GAndrews98/SeaGlide/README.md

# SeaGlide
### SeaGlide AUV files included in this repository:
* Detailed Build Manual
* 3D Printed Parts
* IRRemote Header Files
* Glider Arduino Code V1_0.ino
* Bill of Materials
* Folder of advanced firmware for gliders with Temp/Depth sensors

### Links to necessary Programs and Drivers
[Download: Arduino IDE](http://www.arduino.org/downloads)

[Download: FTDI Drivers for Windows](http://www.ftdichip.com/Drivers/VCP.htm)
