GAndrews98/SeaGlide/Sensor_Firmware/ReadMe.md

# Sensor_Firmware

Arduino code to be run on gliders utilizing temperature and depth sensors.
