GAndrews98/SeaGlide/SeaGlideBOM.xlsx

SeaGlide Bill of Materials | Item | #/Glider |  | #/pack | Item # |  | Glider/Pack | price | Price/ glider |  | link | http://www.mcmaster.com/#
McMaster | 5/16"-18 Bolt 2-1/4" Length | 1 |  | 10 | 92240A932 (http://www.mcmaster.com/) |  | 0.10 | $4.73 | $0.47 |  | http://www.mcmaster.com/#92240A932
 | Tygon Tubing | 1.5 | in | 12 | 5186T14 (http://www.mcmaster.com/) |  | 0.12 | $1.77 | $0.22 |  | http://www.mcmaster.com/#5186T14
 | Steel Bar 1/4"x1"x6" | 2 |  | 1 | 8910K383 |  | 2.00 | $2.75 | $5.50 |  | http://www.mcmaster.com/#8910K383
 | small zip ties | 3 |  | 100 | 6705K31 (http://www.mcmaster.com/) |  | 0.03 | $7.12 | $0.21 |  | http://www.mcmaster.com/#6705K31
 | large zip tie | 2 |  | 100 | 7130K56 (http://www.mcmaster.com/) | 10 | 0.02 | $14.75 | $0.29 |  | http://www.mcmaster.com/#7130K56
 | Brass 6/16-18 nuts (jam nuts, thin) | 1 |  | 25 | 92174A030 (http://www.mcmaster.com/) |  | 0.04 | $6.44 | $0.26 | $1.66 | http://www.mcmaster.com/#92174A030
 | 3/8" ID 1" OD washer Stainless | 1 |  | 100 | 92141A051 |  | 0.01 | $7.66 | $0.08 | $0.59 | http://www.mcmaster.com/#92141A051
 | #6 1/2" Thread-Cutting Screws | 15 |  | 100 | 94629A680 |  | 0.15 | $5.59 | $0.84 |  | http://www.mcmaster.com/#94629A680
 | #2 x3/8 Sheet Metal Stainless | 12 |  | 100 | 90065A079 |  | 0.12 | $3.10 | $0.37 |  | http://www.mcmaster.com/#90065a079/=snxfsx
 | #4-40 washer | 11 |  | 500 | 98019A309 (http://www.mcmaster.com/) |  | 0.022 | $9.63 | $0.21 |  | http://www.mcmaster.com/#98019A309
 | Polystyrine sheet 1/16" | 1 ft^2 |  | 40x72 | 8734K22 (http://www.mcmaster.com/) |  | 0.06 | $29.03 | $1.61 |  | http://www.mcmaster.com/#8734K22
 | Heat Shrink Tubing 1/8-1/16 ID | 4 | in | 48 | 7856K133 (http://www.mcmaster.com/) |  | 0.08 | $1.82 | $0.15 |  | http://www.mcmaster.com/#7856K133
 | RTV silicone | 0.03 | oz | 1 | 7474A14 |  | 0.03 | $6.04 | $0.20 |  | http://www.mcmaster.com/#7474A14
 | 3M Super33+ Electrical Tape | 1 | in | 66 | 76455A22 |  | 0.0152 | $5.65 | $0.09 |  | http://www.mcmaster.com/
Amazon | Ballast Weight strip (3oz) | 1 |  | 6 |  |  | 0.167 | $9.25 | $1.54 |  | http://www.amazon.com/Motion-Pro-08-0455-Black-Weight/dp/B002KQY92W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
 | Li-Ion 9V 4 Pack +Charger | 1 |  | 4 |  |  | 0.250 | $22.99 | $5.75 |  | http://www.amazon.com/EBL-Self-Discharge-Lithium-ion-Rechargeable-Batteries/dp/B00EQ3U2AA
 | popsicle stick | 1 |  | 100 |  |  | 0.01 | $5.67 | $0.06 |  | http://www.amazon.com/Wooden-Treat-Sticks-100-Pcs/dp/B000MMKPEC
 | 3D printed plastic parts | 6 |  |  |  |  |  |  |  | est | $15.00 | jyapchua@gmail.com | or from someone on http://www.makexyz.com/
 | 3D Printer Plus 5 Reels of PLA | 1 |  | 100 |  |  | 0.01 | $924.99 | $9.25 |  | XYZ Printer (700+5*45)
Walmart | BBs (~200grams) | 1 |  | 7 |  |  | 0.14 | $6.97 | $1.00 |  | http://www.walmart.com/ip/Daisy-6000ct-BB-Ammo/15729973
Digikey | 3' Male A USB -> Mini B Male USB | 1 |  | 100 | Q362-ND |  | 0.01 | $176.04 | $1.76 |  | http://www.digikey.com/product-detail/en/3021003-03/Q362-ND/1531289
 | 10k trim pot | 1 |  | 100 | D4AA14-ND | $0.20 | 0.01 | $20.02 | $0.20 |  | http://www.digikey.com/scripts/DkSearch/dksus.dll?WT.z_header=search_go&lang=en&x=0&y=0&cur=USD
 | 5 ohm 0.6W resistor | 1 |  | 100 | BC4.70ZCT-ND |  | 0.01 | $0.00 | $0.00 |  | http://www.digikey.com/product-detail/en/MBB02070C4708FRP00/BC4.70ZCT-ND/2945833
 | 9V Battery Clip | 1 |  | 100 | 36-232-ND |  | 0.01 | $34.76 | $0.35 |  | http://www.digikey.com/product-detail/en/232/36-232-ND/303804
 | push push power switch | 1 |  | 100 | 515PB-ND |  | 0.01 | $134.24 | $1.34 |  | http://www.digikey.com/product-detail/en/40-3979-00/515PB-ND/523397
 | 12 Pin Right Angle Female Header | 1 |  | 100 | S5448-ND |  | 0.01 | $61.00 | $0.61 |  | http://www.digikey.com/product-detail/en/PPTC121LGBN-RC/S5448-ND/775906 |  |  |  | save by buying from DigiKey |  | 0.5
 | male header rt angle 0.1 pitch 36pin | 0.5 |  | 50 | WM50026-36-ND |  | 0.01 | $75.42 | $0.75 |  | http://www.digikey.com/product-detail/en/0022288363/WM50026-36-ND/314241 |  |  |  |  |  | 0.5
 | hook up wire / ribbin cable | 12 | in | 100 | T1309-30-ND |  | 0.01 | $36.01 | $0.36 |  | http://www.digikey.com/product-detail/en/30-00419/T1309-30-ND/5638242
 | Tactile Switch w/ long stem | 1 |  | 100 | EG4566CT-ND | $0.26 | 0.01 | $0.27 | $0.002665 |  | http://www.digikey.com/product-detail/en/TL59FF160Q/EG4566CT-ND/1767496
 | socket pins 8pin | 1 |  | 100 | 1212-1097-ND |  | 0.01 | $36.96 | $0.37 |  | http://www.digikey.com/product-detail/en/310-87-108-41-001101/1212-1097-ND/3757347
Sparkfun | FTDI Basic Breakout - 5V | 1 |  | 100 | 9716 |  | 0.01 | $1196.00 | $11.96 |  | https://www.sparkfun.com/products/9716 |  |  | https://www.sparkfun.com/products/ |  | Utilize Sparkfun's 20% educators discount
 | 2 pin JST Pigtail and Right Angle Connector | 1 |  | 100 | 9914 |  | 0.01 | $76.00 | $0.76 |  | https://www.sparkfun.com/products/9914
 | Arduino pro mini 328 - 5V 16MHz | 1 |  | 100 | 11113 |  | 0.01 | $796.00 | $7.96 |  | https://www.sparkfun.com/products/11113
 | Servo - Medium Full Rotation | 1 |  | 100 | 10189 |  | 0.01 | $956.00 | $9.56 |  | https://www.sparkfun.com/products/10189
Adafuit | IR reciever | 1 |  | 50 | 157 |  | 0.02 | $73.00 | $1.46 |  | http://www.adafruit.com/products/157?&main_page=product_info&cPath=35&products_id=157
 | RGB LED | 1 |  | 100 | 302 |  | 0.01 | $80.00 | $0.80 |  | http://www.adafruit.com/products/302
 | IR Remote | 1 |  | 1 | 389 |  | 1.00 | $4.95 | $4.95 |  | http://www.adafruit.com/product/389
Oshpark Custom PCB | SeaGlide PCB | 1 |  | 3 | SeaGlide |  | 0.33 | $7.95 | $2.65 |  | https://oshpark.com/profiles/SeaGlide
 |  |  |  |  |  |  |  |  |  |  |  |  |  |  |  |  | 0.3
Nathan | Nathan Water Bottle | 1 |  | 1 | 700 ml |  | 1 | $6.50 | $6.50 |  | Bulk rate, direct from Nathan |  | http://www.amazon.com/Nathan-700ml-Tritan-Bottle-Straw/dp/B00198U6TW?s=sporting-goods
EastWest Hydro | 100 cc syringe | 1 |  | 1 | 100CC |  | 1 | $4.29 | $4.29 |  | http://eastwesthydro.com/garden-supplies/measurement-tools/ecoplus/ecoplus-measure-master-syringe-100cc-740610 |  |  |  | Should be able to reduce by $3+ by buying in bulk |  | 3
 |  |  |  |  |  |  |  |  | $76.49 | Glider Total |  |  |  |  |  |  | $72.19
Mechanical Bag
Electronics Bag
