GAndrews98/SeaGlide/(commit log)

2016-08-07 Soft(ware) Limits to plunger && Variable LED
    Soft limits to plunger position: defined by MaxPistonPosition (old
    risetime variable) and 0 (hitting the stop switch).
    These values are mapped to the LED to change between RED (diving) and
    BLUE (rising) with purple being the mid-point (eventually neutral
    buoyancy).
2016-08-08 Removed Vertical Velocity Calculation
    Took out some old commented code and removed vertical velocity from
    code. Should be ready to test before merging back into Master code.
2016-08-08 Fixed Servo Run Issues
    [SeaGlideV1_1.ino.ino]
